Neuromancer43/Ultraino/8x8+integrated+PCB/connectors.txt

https://www.conrad.de/de/buchsenleiste-standard-anzahl-reihen-2-polzahl-je-reihe-8-econ-connect-bl82g8-1-st-1303515.html
