Neuromancer43/Ultraino/Notification/卓越杯报名表-重庆大学.pdf

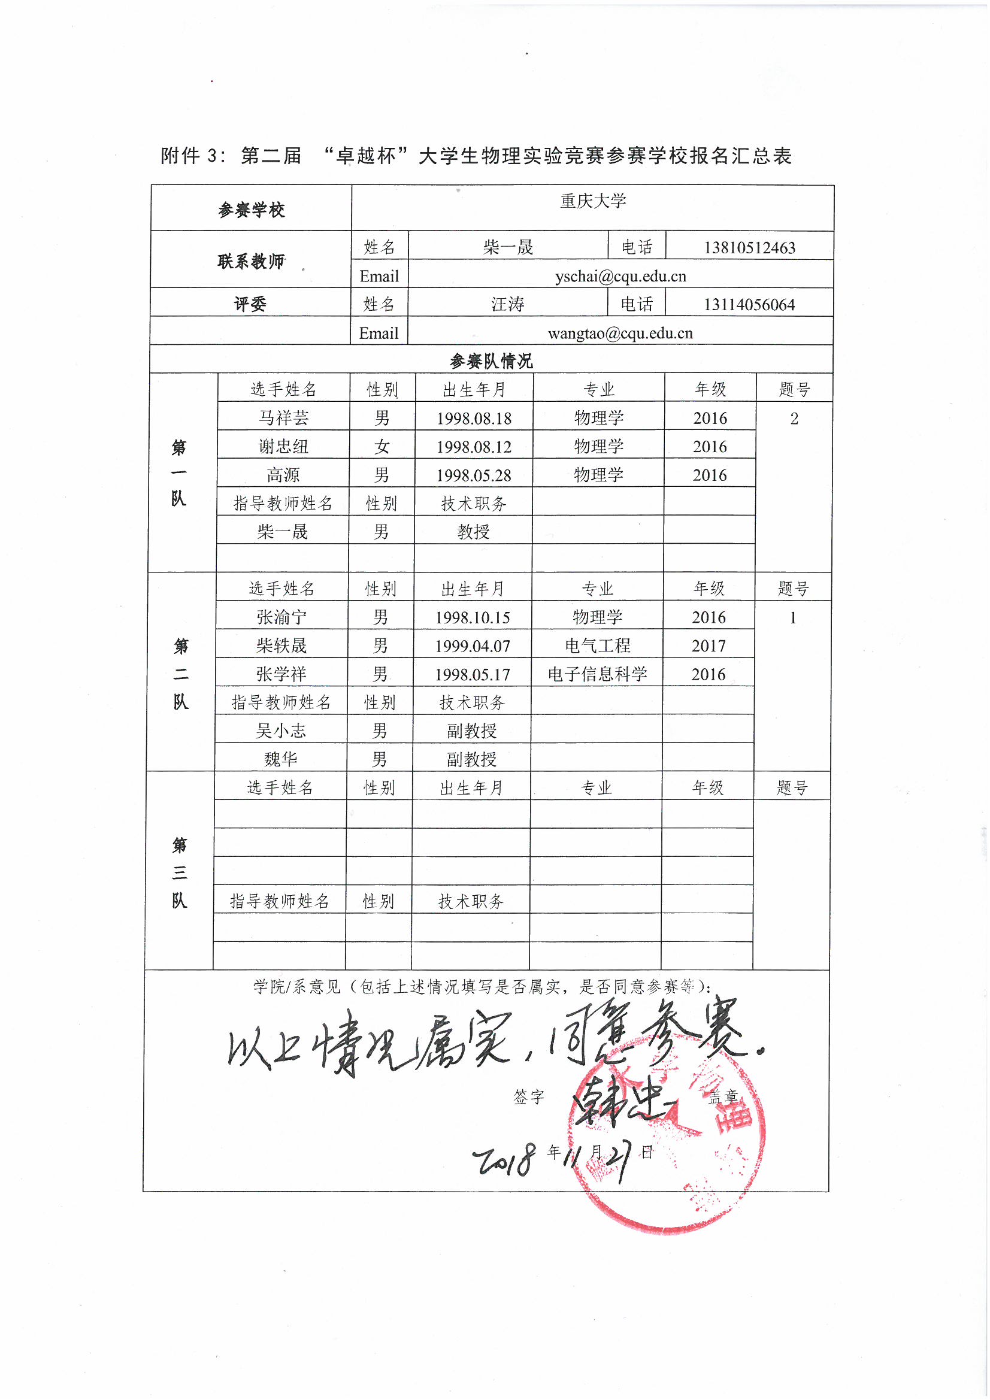
[picture p11: page 1]
