Neuromancer43/Ultraino/8x8+integrated+PCB/Ultrasonic Array_8x8.brd

## EAGLE design 8x8+integrated+PCB/Ultrasonic Array_8x8.brd (2018-10-01)

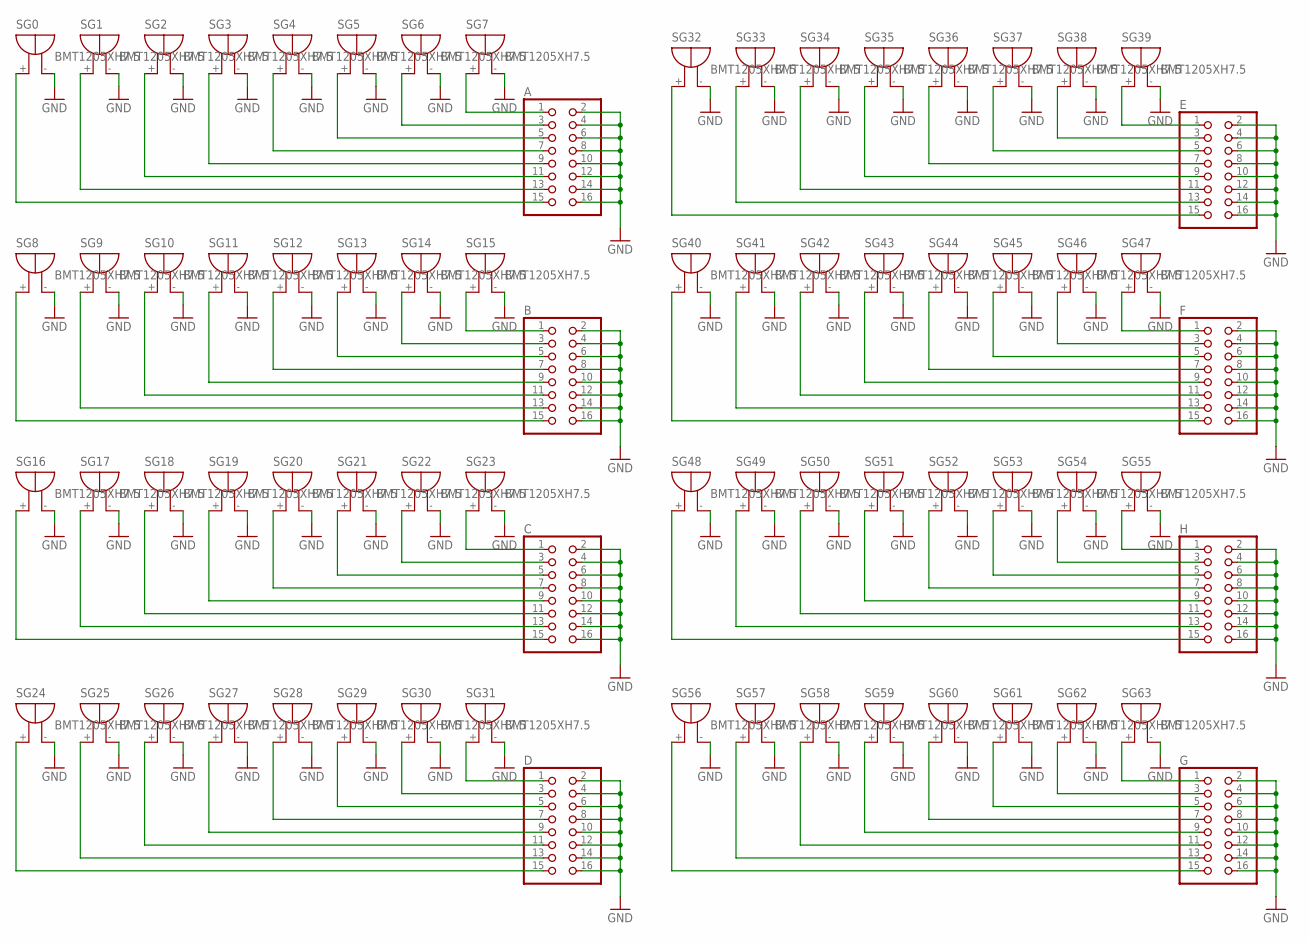
[picture p12: schematic Ultrasonic Array_8x8.sch]

Parts:
A: PINHD-2X8; 2X08
B: PINHD-2X8; 2X08
C: PINHD-2X8; 2X08
D: PINHD-2X8; 2X08
E: PINHD-2X8; 2X08
F: PINHD-2X8; 2X08
G: PINHD-2X8; 2X08
H: PINHD-2X8; 2X08
SG0, SG1, SG2, SG3, SG4, SG5, SG6, SG7, SG8, SG9, SG10, SG11, SG12, SG13, SG14, SG15, SG16, SG17, SG18, SG19, SG20, SG21, SG22, SG23, SG24, SG25, SG26, SG27, SG28, SG29, SG30, SG31, SG32, SG33, SG34, SG35, SG36, SG37, SG38, SG39, SG40, SG41, SG42, SG43, SG44, SG45, SG46, SG47, SG48, SG49, SG50, SG51, SG52, SG53, SG54, SG55, SG56, SG57, SG58, SG59, SG60, SG61, SG62, SG63: BMT1205XH7.5

Connections:
GND: A.2, A.4, A.6, A.8, A.10, A.12, A.14, A.16, B.2, B.4, B.6, B.8, B.10, B.12, B.14, B.16, C.2, C.4, C.6, C.8, C.10, C.12, C.14, C.16, D.2, D.4, D.6, D.8, D.10, D.12, D.14, D.16, E.2, E.4, E.6, E.8, E.10, E.12, E.14, E.16, F.2, F.4, F.6, F.8, F.10, F.12, F.14, F.16, G.2, G.4, G.6, G.8, G.10, G.12, G.14, G.16, H.2, H.4, H.6, H.8, H.10, H.12, H.14, H.16, SG0.-, SG1.-, SG2.-, SG3.-, SG4.-, SG5.-, SG6.-, SG7.-, SG8.-, SG9.-, SG10.-, SG11.-, SG12.-, SG13.-, SG14.-, SG15.-, SG16.-, SG17.-, SG18.-, SG19.-, SG20.-, SG21.-, SG22.-, SG23.-, SG24.-, SG25.-, SG26.-, SG27.-, SG28.-, SG29.-, SG30.-, SG31.-, SG32.-, SG33.-, SG34.-, SG35.-, SG36.-, SG37.-, SG38.-, SG39.-, SG40.-, SG41.-, SG42.-, SG43.-, SG44.-, SG45.-, SG46.-, SG47.-, SG48.-, SG49.-, SG50.-, SG51.-, SG52.-, SG53.-, SG54.-, SG55.-, SG56.-, SG57.-, SG58.-, SG59.-, SG60.-, SG61.-, SG62.-, SG63.-
unnamed: A.1, SG7.+
unnamed: A.3, SG6.+
unnamed: A.5, SG5.+
unnamed: A.7, SG4.+
unnamed: A.9, SG3.+
unnamed: A.11, SG2.+
unnamed: A.13, SG1.+
unnamed: A.15, SG0.+
unnamed: B.1, SG15.+
unnamed: B.3, SG14.+
unnamed: B.5, SG13.+
unnamed: B.7, SG12.+
unnamed: B.9, SG11.+
unnamed: B.11, SG10.+
unnamed: B.13, SG9.+
unnamed: B.15, SG8.+
unnamed: C.1, SG23.+
unnamed: C.3, SG22.+
unnamed: C.5, SG21.+
unnamed: C.7, SG20.+
unnamed: C.9, SG19.+
unnamed: C.11, SG18.+
unnamed: C.13, SG17.+
unnamed: C.15, SG16.+
unnamed: D.1, SG31.+
unnamed: D.3, SG30.+
unnamed: D.5, SG29.+
unnamed: D.7, SG28.+
unnamed: D.9, SG27.+
unnamed: D.11, SG26.+
unnamed: D.13, SG25.+
unnamed: D.15, SG24.+
unnamed: E.1, SG39.+
unnamed: E.3, SG38.+
unnamed: E.5, SG37.+
unnamed: E.7, SG36.+
unnamed: E.9, SG35.+
unnamed: E.11, SG34.+
unnamed: E.13, SG33.+
unnamed: E.15, SG32.+
unnamed: F.1, SG47.+
unnamed: F.3, SG46.+
unnamed: F.5, SG45.+
unnamed: F.7, SG44.+
unnamed: F.9, SG43.+
unnamed: F.11, SG42.+
unnamed: F.13, SG41.+
unnamed: F.15, SG40.+
unnamed: H.1, SG55.+
unnamed: H.3, SG54.+
unnamed: H.5, SG53.+
unnamed: H.7, SG52.+
unnamed: H.9, SG51.+
unnamed: H.11, SG50.+
unnamed: H.13, SG49.+
unnamed: H.15, SG48.+
unnamed: G.1, SG63.+
unnamed: G.3, SG62.+
unnamed: G.5, SG61.+
unnamed: G.7, SG60.+
unnamed: G.9, SG59.+
unnamed: G.11, SG58.+
unnamed: G.13, SG57.+
unnamed: G.15, SG56.+

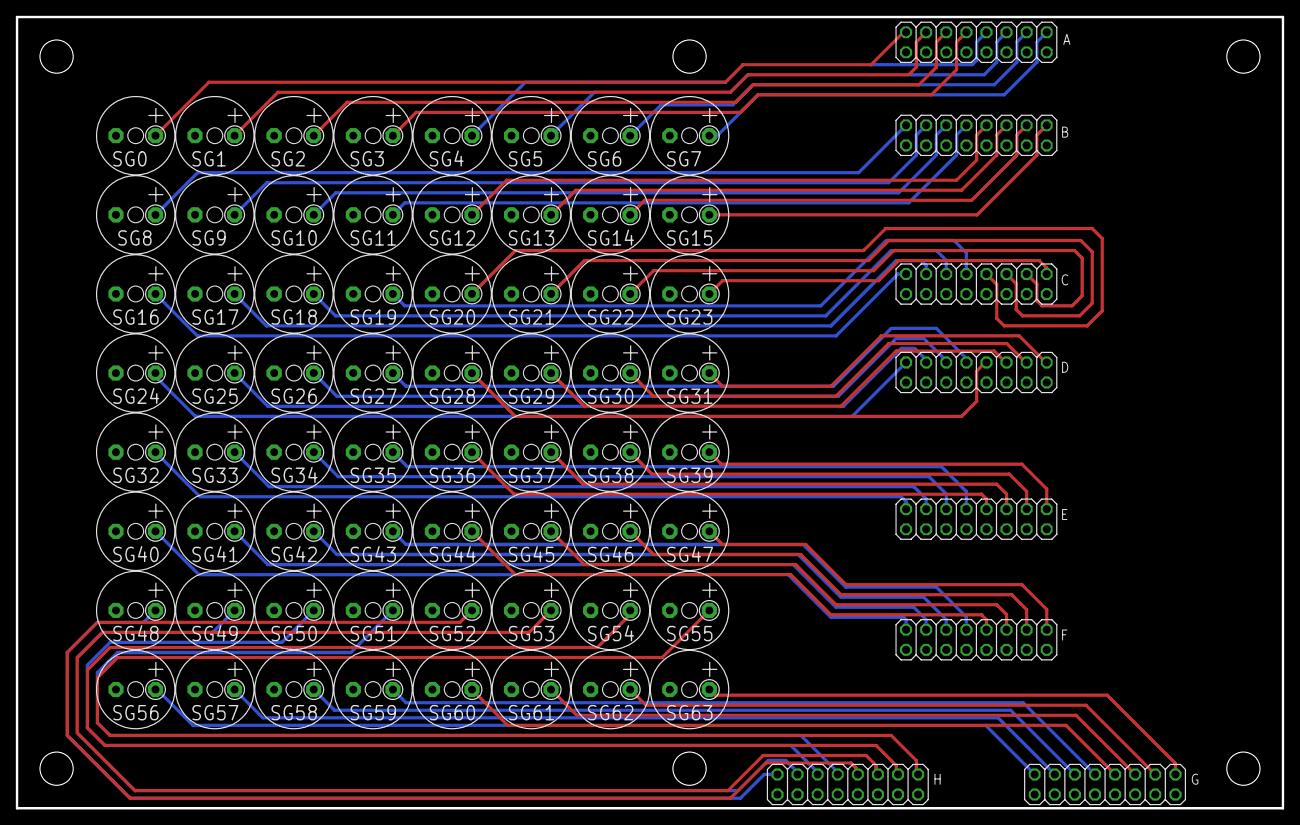
[picture p13: board Ultrasonic Array_8x8.brd from above]

Board: 2 copper layers, 160.0 x 100.0 mm, 72 parts (0 on the bottom side), 65 nets.
