Neuromancer43/Ultraino/Test_Log/array_data01.xlsx

Sheet: cap45
Transducer | V1 | V2 | V3 | V4 | V-bar | STD-DEV | RATIO | CH1-CH2 | PHASE
1 | 2.6 | 3.18 | 2.8 | 2.82 | 2.85 | 0.2413848932 | 8.47% | 0.00 | 0
2 | 3.3 | 3.26 | 3.16 | 3.48 | 3.3 | 0.133666251 | 4.05% | 4.60 | 0.368
3 | 3.94 | 4.02 | 4.08 | 3.86 | 3.975 | 0.09574271078 | 2.41% | 1.40 | 0.112
4 | 2.8 | 2.92 | 2.68 | 3.06 | 2.865 | 0.162788206 | 5.68% | 1.40 | 0.112
5 | 4.38 | 4.04 | 4.06 | 4.06 | 4.135 | 0.1636052159 | 3.96% | 3.40 | 0.272
6 | 3.02 | 3.12 | 3.2 | 3.26 | 3.15 | 0.1039230485 | 3.30% | 3.80 | 0.304
7 | 4.12 | 3.32 | 3.44 | 3.8 | 3.67 | 0.3627671429 | 9.88% | 3.40 | 0.272
8 | 4.16 | 4.3 | 4.32 | 4.16 | 4.235 | 0.086986589 | 2.05% | 3.00 | 0.24
9 | 3.96 | 4.08 | 4.46 | 4.3 | 4.2 | 0.2233084563 | 5.32% | 0.00 | 0
10 | 4.62 | 4.64 | 4.48 | 4.46 | 4.55 | 0.09309493363 | 2.05% | 2.60 | 0.208
11 | 3.72 | 3.7 | 3.7 | 3.7 | 3.705 | 0.01 | 0.27% | 1.40 | 0.112
12 | 3.72 | 3.86 | 3.82 | 3.94 | 3.835 | 0.09146948489 | 2.39% | 2.40 | 0.192
13 | 3.42 | 3.76 | 3.66 | 3.74 | 3.645 | 0.1560982597 | 4.28% | 1.40 | 0.112
14 | 3.62 | 3.6 | 3.66 | 3.42 | 3.575 | 0.1063014581 | 2.97% | 0.40 | 0.032
15 | 3.88 | 3.9 | 3.84 | 4 | 3.905 | 0.06806859286 | 1.74% | 0.80 | 0.064
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
