Neuromancer43/Ultraino/Test_Log/problem_analysis.txt

A. 双面驻波声场
声场分布不随时间变化，虽然空间分布可能不均匀，但是时间分布稳定。

B. 单面行波声场
声场发生装置实际上是行波，场分布随时间周期性波动。
粒子受力不稳定对装置有较高要求：
- 信号稳定性强
- 装置功率足够
- 阵列振幅振幅偏差小，接近精确一致
- 阵列相位偏差小，接近精确一致

* 针对振幅找到解决方案
    1.  大规模测试振子，找到振幅一致振子
* 加装功放，加大功率
* 信号稳定性
    1. 修改Arduino代码
