Neuromancer43/Ultraino/(commit log)

2018-10-01 build project
    [Ultrasonic Array_8x8.brd, Ultrasonic Array_8x8.sch]
2019-06-04 Zhuoyue Cup
    [array_data01.xlsx]
